nguyen-trinhtk/PII-Robot/BottleDetection/Past-versions/calibrate/images/image2.jpg

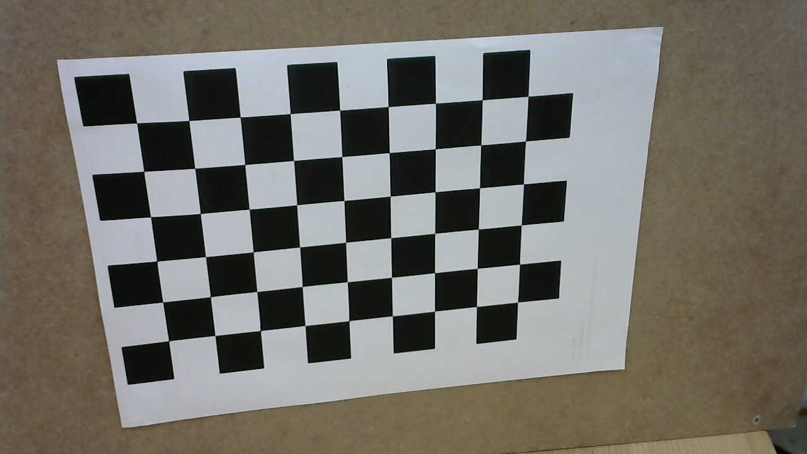
BottleDetection/Past-versions/calibrate/images/image2.jpg
