nguyen-trinhtk/PII-Robot/BottleDetection/Past-versions/calibrate/images/image4.jpg

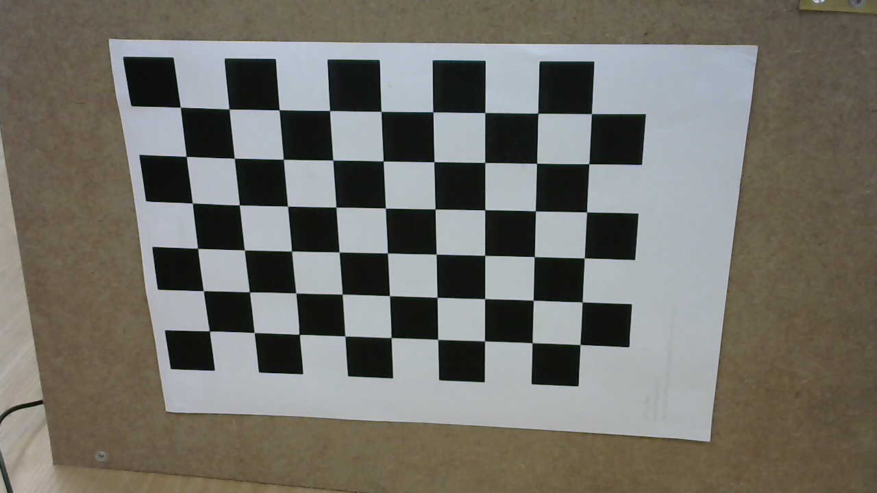
BottleDetection/Past-versions/calibrate/images/image4.jpg
