nguyen-trinhtk/PII-Robot/RobotDesign/Build-0-v9.stl

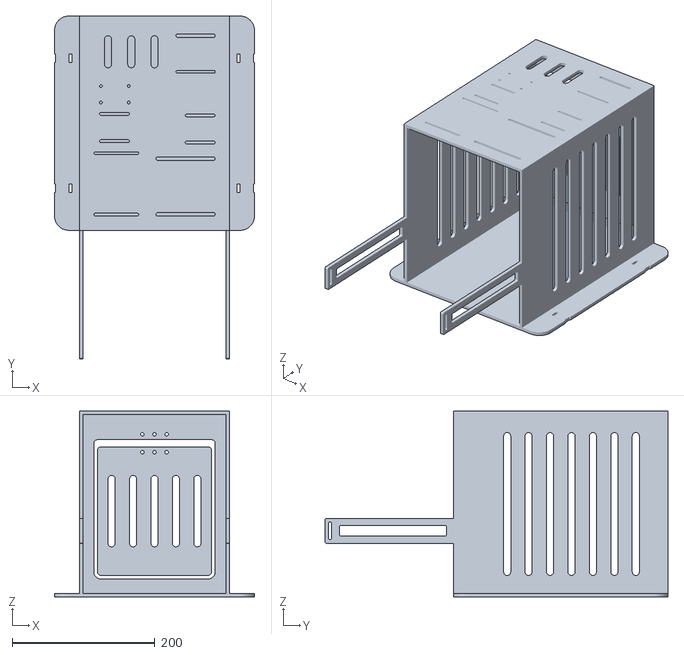
[picture p8: CAD file, 2023-09-23]
RobotDesign/Build-0-v9.stl
280.0 x 480.0 x 260.0
