nguyen-trinhtk/PII-Robot/BottleDetection/Past-versions/calibrate/caliResult.png

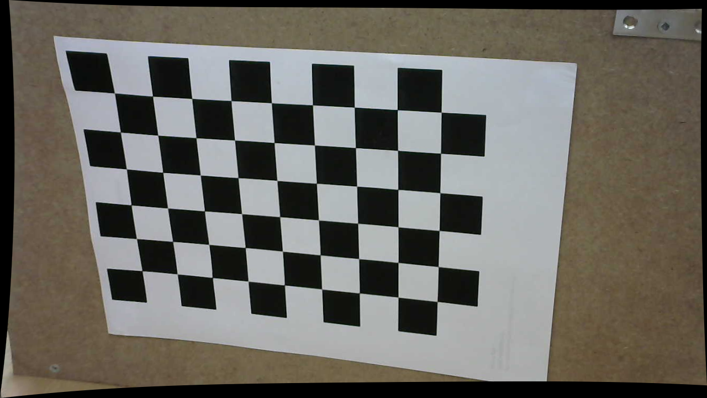
BottleDetection/Past-versions/calibrate/caliResult.png
