nguyen-trinhtk/PII-Robot/BottleDetection/Past-versions/calibrate/images/image0.jpg

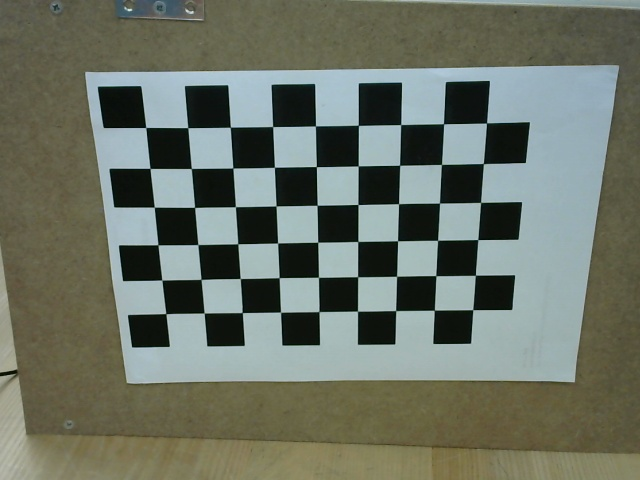
BottleDetection/Past-versions/calibrate/images/image0.jpg
