nguyen-trinhtk/PII-Robot/BottleDetection/Past-versions/calibrate/images/image1.jpg

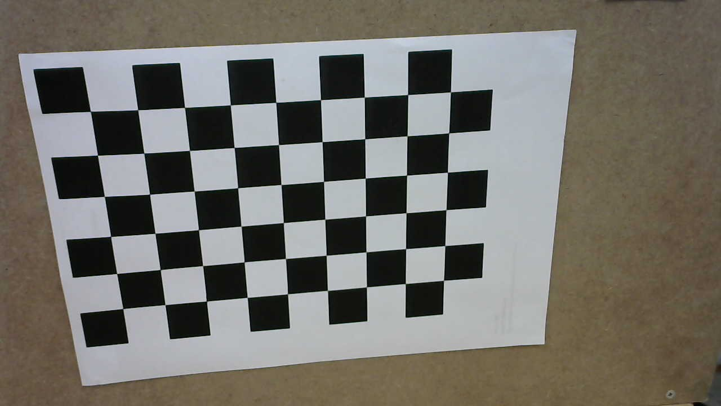
BottleDetection/Past-versions/calibrate/images/image1.jpg
