nguyen-trinhtk/PII-Robot/BottleDetection/Past-versions/calibrate/images/image3.jpg

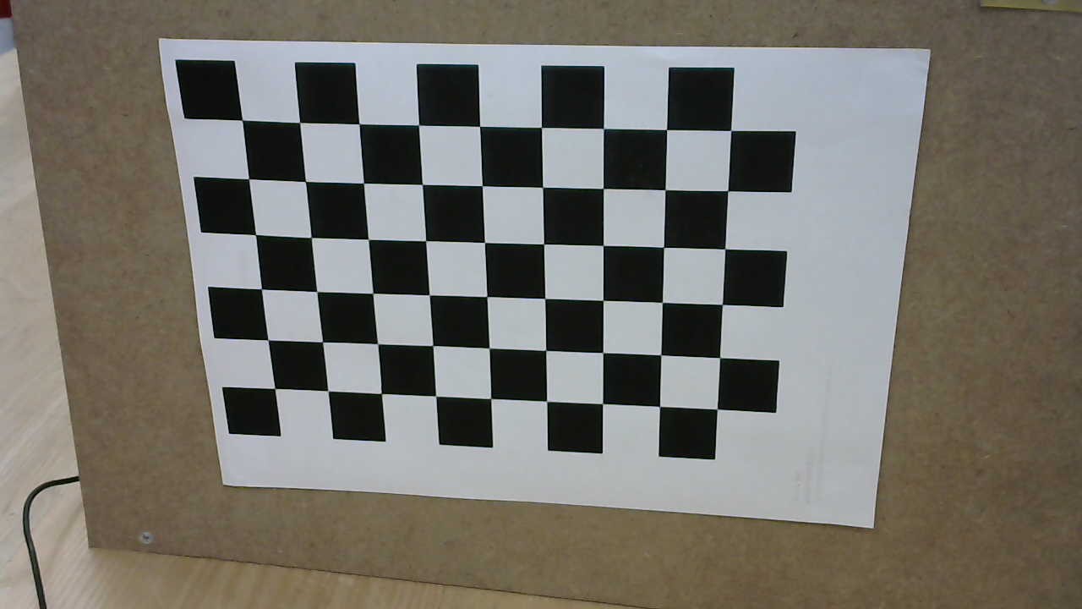
BottleDetection/Past-versions/calibrate/images/image3.jpg
