nguyen-trinhtk/PII-Robot/BottleDetection/Past-versions/calibrate/images/image5.jpg

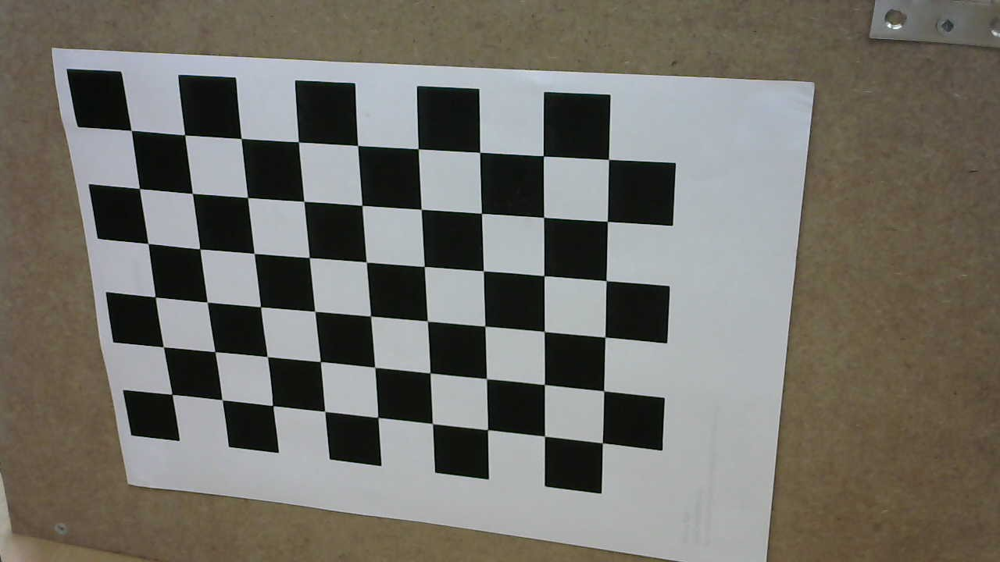
BottleDetection/Past-versions/calibrate/images/image5.jpg
