nguyen-trinhtk/PII-Robot/(commit log)

2023-07-11 July 11, 9:35
    Added serial communication between python and Arduino to control movement by keyboard (arrow + wasd)
2023-07-11 July 11, 11:49
    Fixed distance formula (error: 10cm at distance > 1m)
    [bottle.py]
2023-07-24 July 24, 13:54
    Added Arduino serial comm
2023-07-31 Create lidar
2023-08-09 August 9, 10:21
    Added lidar-camera
2023-09-23 September 23, 16:22
    Added Robot design
    [Build-0-v9.stl]
2023-09-30 September 30, 10:52
    [Build-0-v9.stl]
